suryan-s/AWS-v0.1/(commit log)

2022-01-09 Updated with PCB files and image
2022-01-09 updated README.md and included PCB files
